r1cebank/Monotech-Bootable-HD-Floppy-Serial/Images/Back bare.png

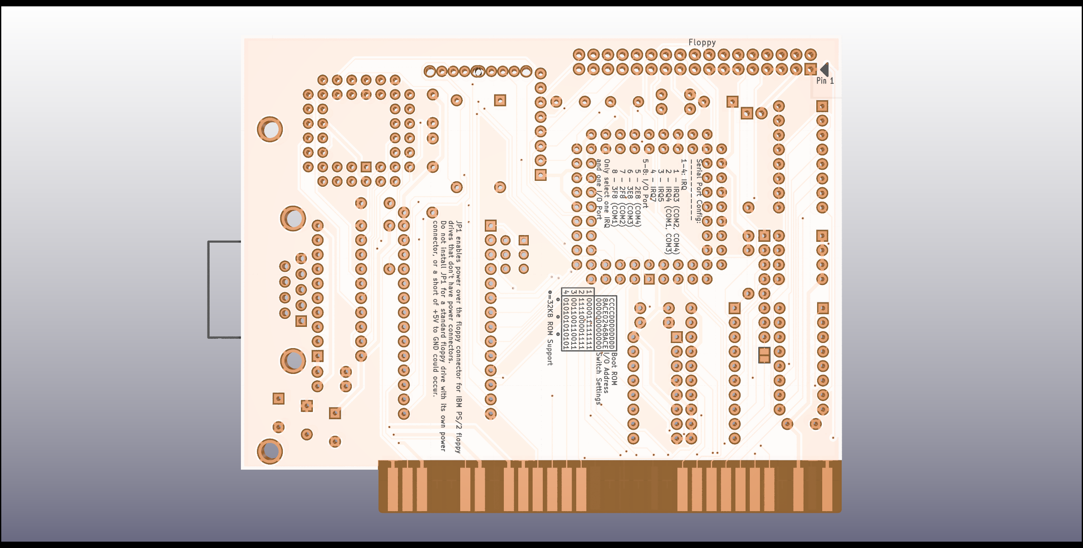
Images/Back bare.png
