r1cebank/Monotech-Bootable-HD-Floppy-Serial/README.md

Monotech Bootable ISA HD-Floppy + Serial Controller Card
----

Based on Sergey Kiselev's (https://github.com/skiselev) design: http://www.malinov.com/Home/sergeys-projects/isa-fdc-and-uart

The unlabeled solder-jumper on the back of the PCB pulls down D7.
