r1cebank/Monotech-Bootable-HD-Floppy-Serial/Images/Front bare.png

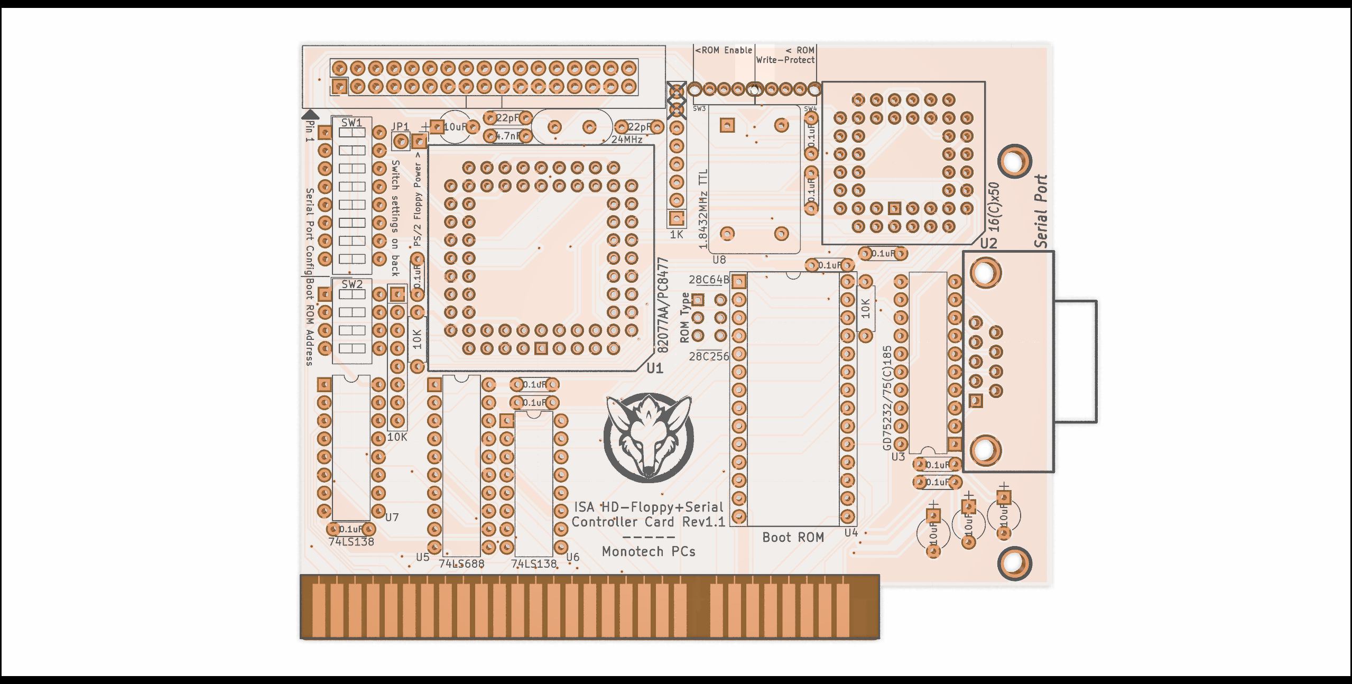
Images/Front bare.png
