r1cebank/Monotech-Bootable-HD-Floppy-Serial/Images/Profile with parts.png

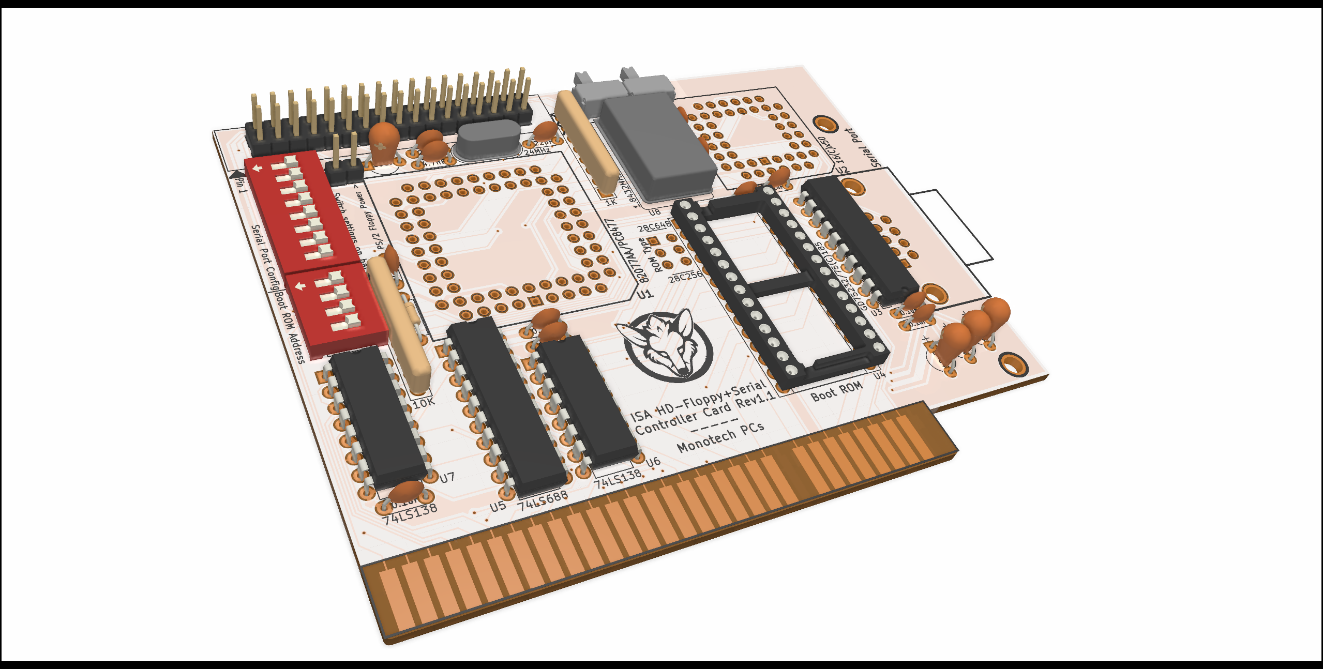
Images/Profile with parts.png
