r1cebank/Monotech-Bootable-HD-Floppy-Serial/3Dmodels/OS102011MA1QN1.stp

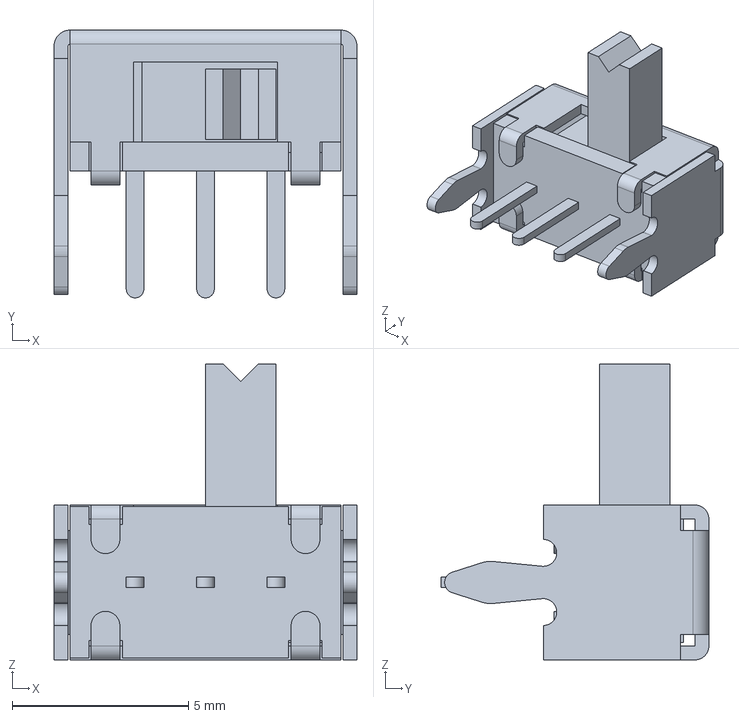
[picture p4: CAD file, 2018-11-04]
3Dmodels/OS102011MA1QN1.stp
8.60 x 7.60 x 8.40 mm
