r1cebank/Monotech-Bootable-HD-Floppy-Serial/(notices)

Notices in the files:
Monotech-HD-Floppy-Serial.kicad_pcb:
GPL v3
